TataThanapat/CURSR-V-Flight-Computer/Main board/Main board.stl

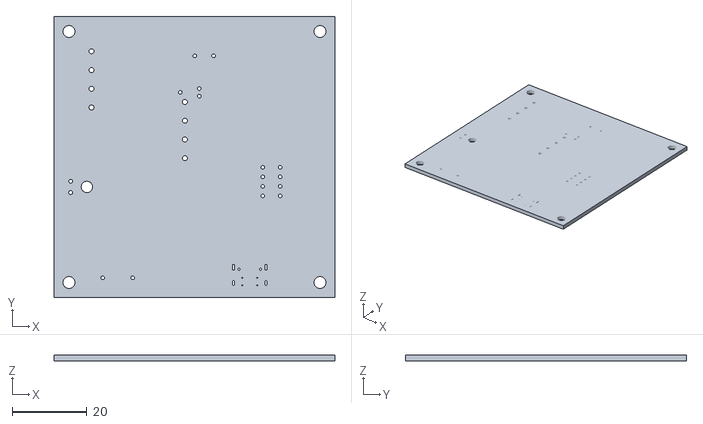
[picture p1: CAD file, 2026-03-27]
Main board/Main board.stl
75.0 x 75.0 x 1.51
