TataThanapat/CURSR-V-Flight-Computer/ICM45686_Breakout/ICM45686_Breakout.kicad_pcb

## KiCad design ICM45686_Breakout/ICM45686_Breakout.kicad_pcb (2026-10-14)

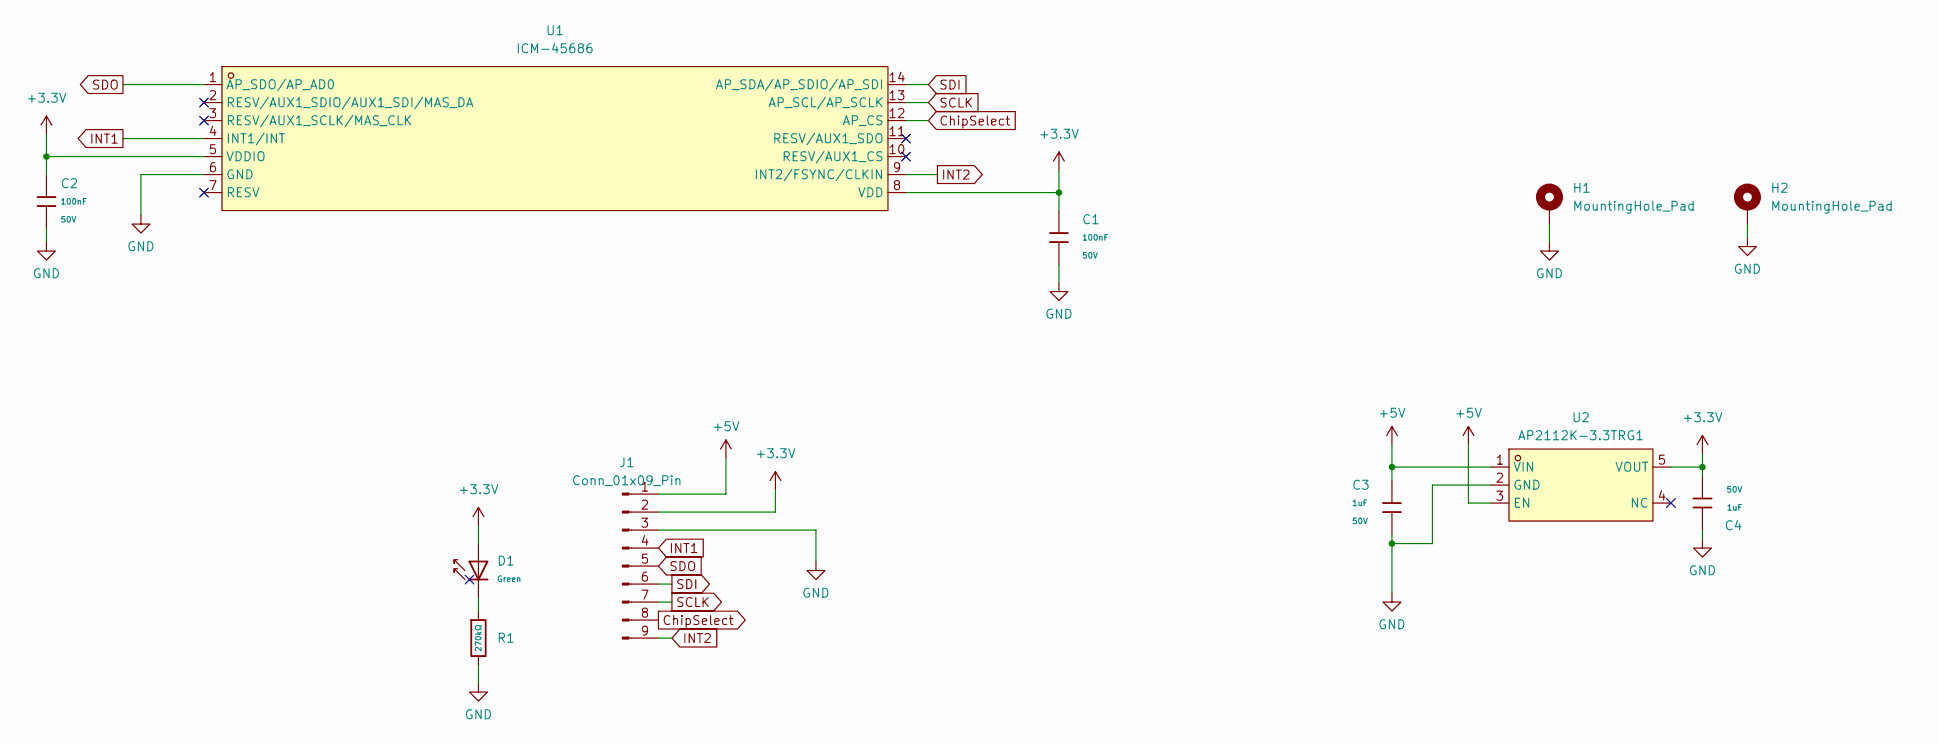
[picture p2: schematic ICM45686_Breakout.kicad_sch]

Parts:
C1, C2: 100nF; C_0603; Voltage Rated 50V; Tolerance ±10%; Part CC0603KRX7R9BB104; LCSC C14663
C3, C4: 1uF; C_0805; Voltage Rated 50V; Tolerance ±10%; Part CL21B105KBFNNNE; LCSC C28323
D1: Green; D_0805; Part KT-0805G; LCSC C2297
H1, H2: MountingHole_Pad; MountingHole_2.2mm_M2_ISO7380_Pad
J1: Conn_01x09_Pin; PinHeader_1x09_P2.54mm_Vertical
R1: 270kΩ; R_0603; Overload Voltage (Max) 75V; Tolerance ±1%; Part 0603WAF2703T5E; LCSC C22965
U1: ICM-45686; LGA-14_L3.0-W2.5-P0.50-TL; LCSC Part C22459454
U2: AP2112K-3.3TRG1; SOT-25-5_L2.9-W1.6-P0.95-LS2.8-BL; LCSC Part C51118

Connections:
+3.3V: C1.1, C2.1, C4.2, D1.2, J1.2, U1.5 (VDDIO), U1.8 (VDD), U2.5 (VOUT)
+5V: C3.1, J1.1, U2.1 (VIN), U2.3 (EN)
ChipSelect: J1.8, U1.12 (AP_CS)
GND: C1.2, C2.2, C3.2, C4.1, H1.1, H2.1, J1.3, R1.2, U1.6 (GND), U2.2 (GND)
INT1: J1.4, U1.4 (INT1/INT)
INT2: J1.9, U1.9 (INT2/FSYNC/CLKIN)
unnamed: D1.1, R1.1
SCLK: J1.7, U1.13 (AP_SCL/AP_SCLK)
SDI: J1.6, U1.14 (AP_SDA/AP_SDIO/AP_SDI)
SDO: J1.5, U1.1 (AP_SDO/AP_AD0)

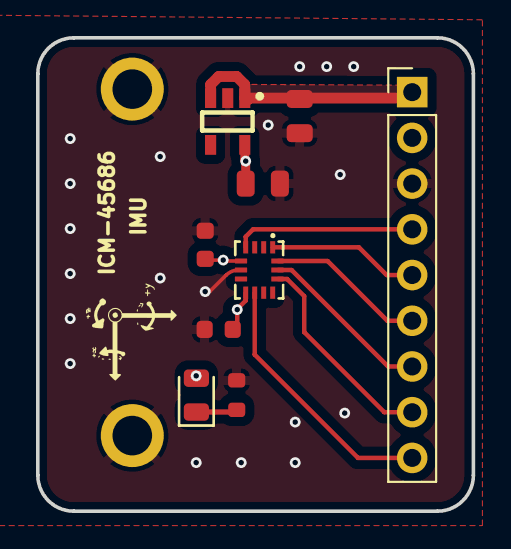
[picture p3: board ICM45686_Breakout.kicad_pcb from above]

Board: 4 copper layers, 24.2 x 26.3 mm, 11 parts (0 on the bottom side), 10 nets.
