TataThanapat/CURSR-V-Flight-Computer/Baro Breakout/Baro Breakout.kicad_pcb

## KiCad design Baro Breakout/Baro Breakout.kicad_pcb (2026-10-14)

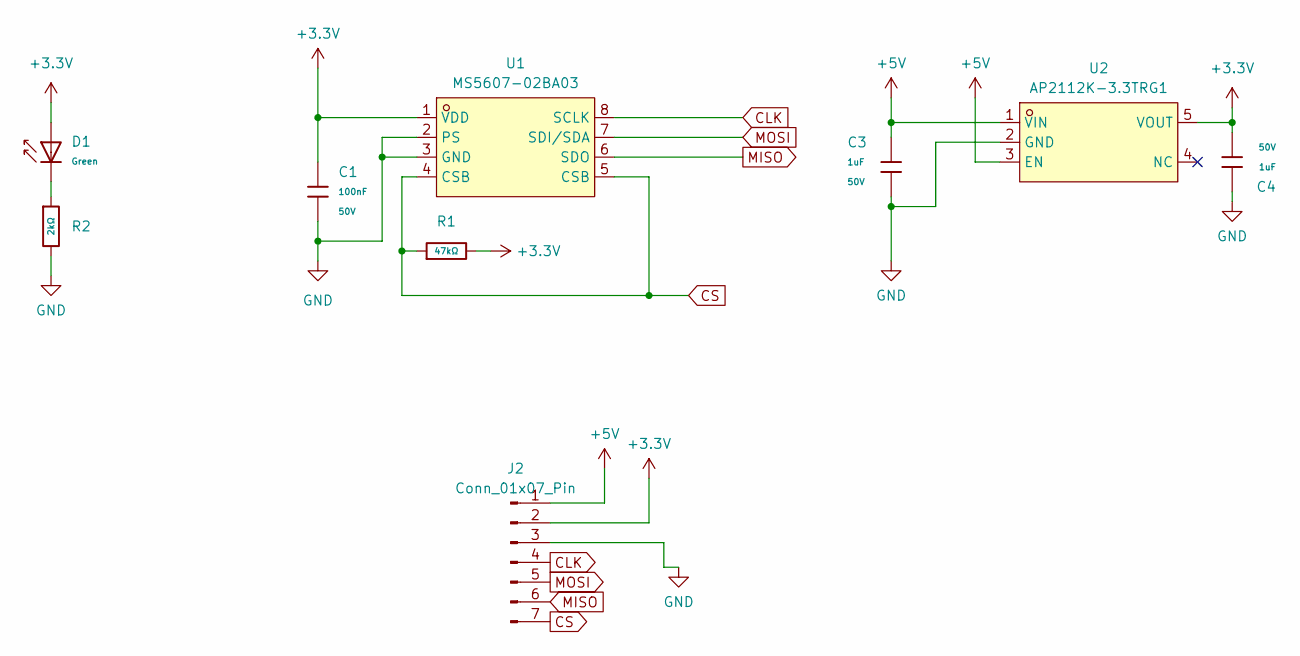
[picture p4: schematic Baro Breakout.kicad_sch]

Parts:
C1: 100nF; C_0603; Voltage Rated 50V; Tolerance ±10%; Part CC0603KRX7R9BB104; LCSC C14663
C3, C4: 1uF; C_0805; Voltage Rated 50V; Tolerance ±10%; Part CL21B105KBFNNNE; LCSC C28323
D1: Green; D_0805; Part KT-0805G; LCSC C2297
J2: Conn_01x07_Pin; PinHeader_1x07_P2.54mm_Vertical
R1: 47kΩ; R_0603; Overload Voltage (Max) 75V; Tolerance ±1%; Part 0603WAF4702T5E; LCSC C25819
R2: 2kΩ; R_0402; Overload Voltage (Max) 50V; Tolerance ±1%; Part 0402WGF2001TCE; LCSC C4109
U1: MS5607-02BA03; SENSOR-SMD_MS560702BA03-50; LCSC Part C9900023641
U2: AP2112K-3.3TRG1; SOT-25-5_L2.9-W1.6-P0.95-LS2.8-BL; LCSC Part C51118

Connections:
+3.3V: C1.1, C4.2, D1.2, J2.2, R1.2, U1.1 (VDD), U2.5 (VOUT)
+5V: C3.1, J2.1, U2.1 (VIN), U2.3 (EN)
CLK: J2.4, U1.8 (SCLK)
CS: J2.7, R1.1, U1.4 (CSB), U1.5 (CSB)
GND: C1.2, C3.2, C4.1, J2.3, R2.2, U1.2 (PS), U1.3 (GND), U2.2 (GND)
MISO: J2.6, U1.6 (SDO)
MOSI: J2.5, U1.7 (SDI/SDA)
unnamed: D1.1, R2.1

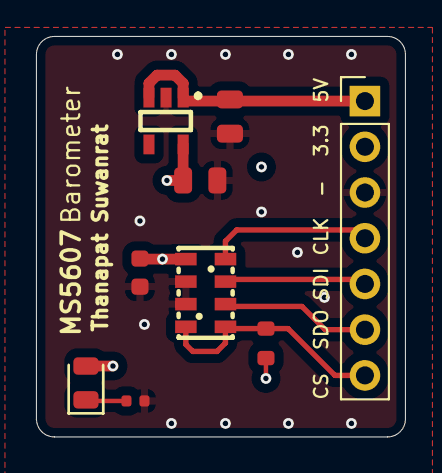
[picture p5: board Baro Breakout.kicad_pcb from above]

Board: 4 copper layers, 20.5 x 22.2 mm, 9 parts (0 on the bottom side), 8 nets.
