TataThanapat/CURSR-V-Flight-Computer/Main board/Main board.kicad_pcb

## KiCad design Main board/Main board.kicad_pcb (2026-10-14)

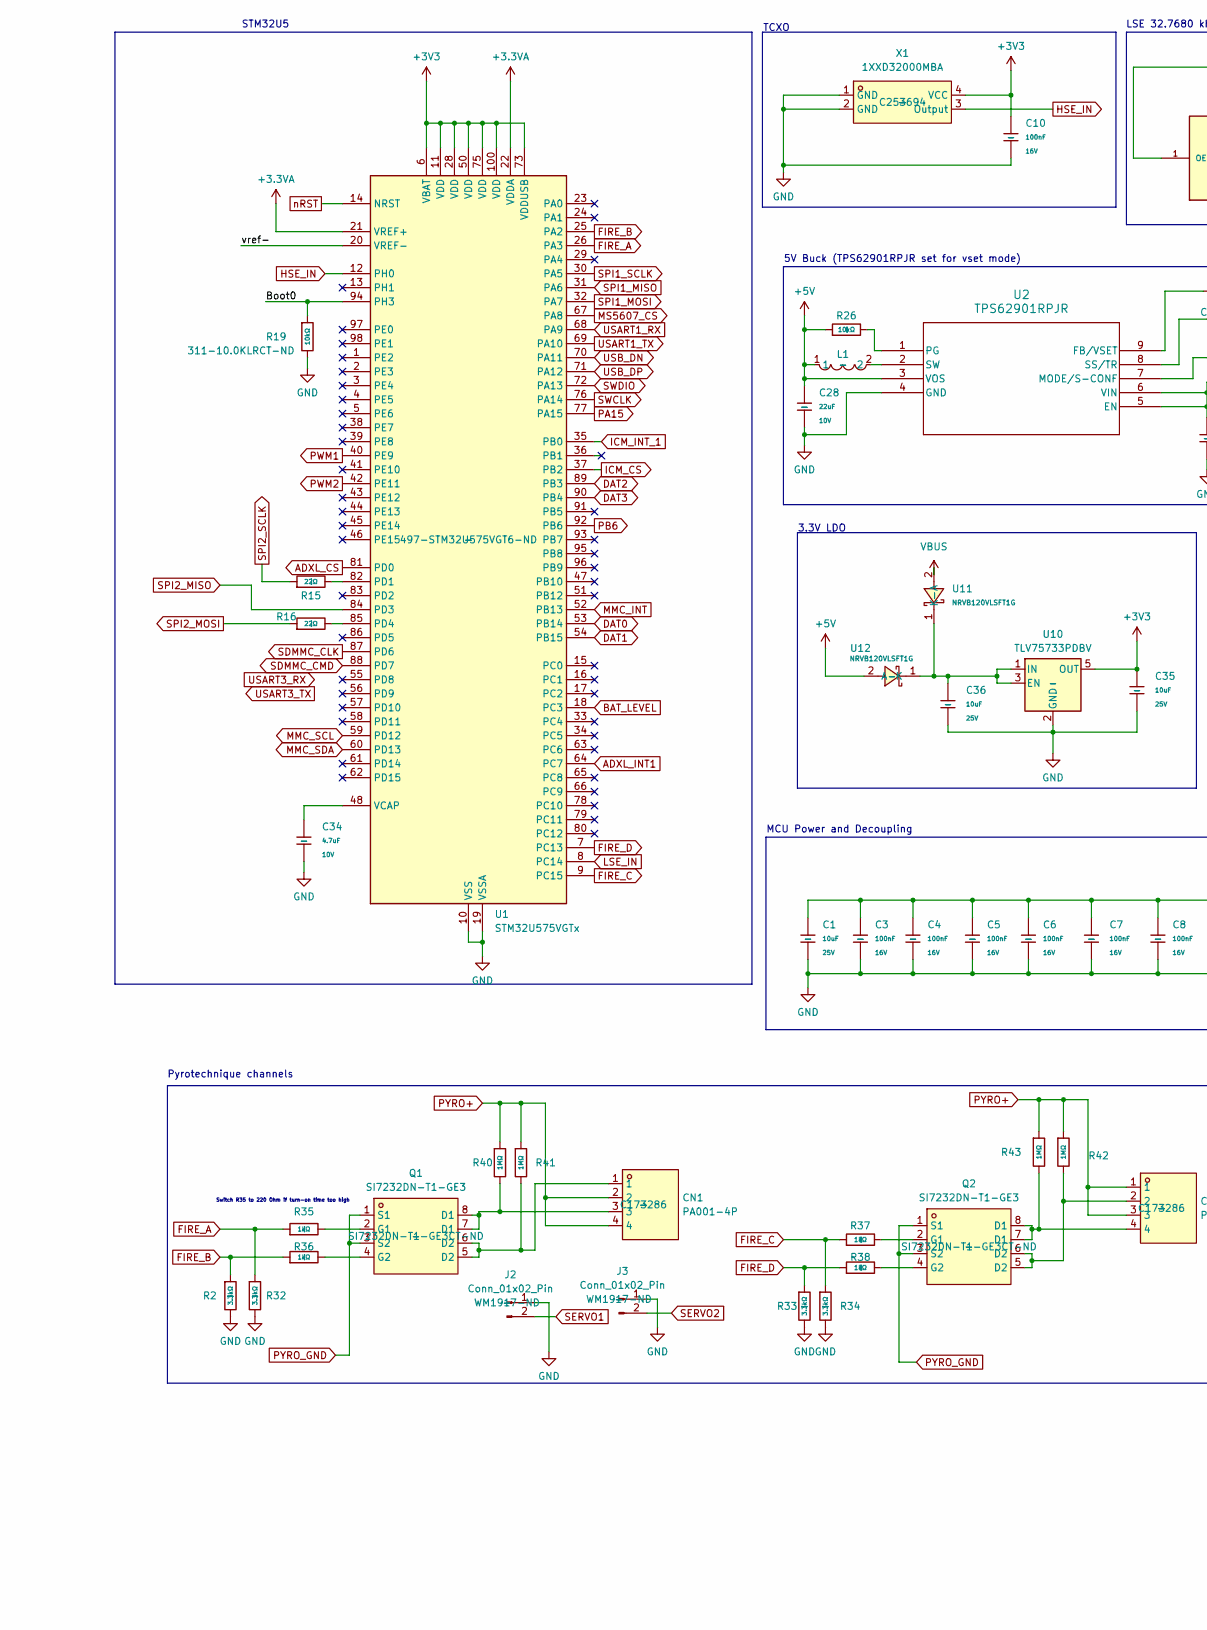
[picture p6: schematic Main board.kicad_sch, CURFA-V SRAD Flight Computer, part in row 1, column 1]

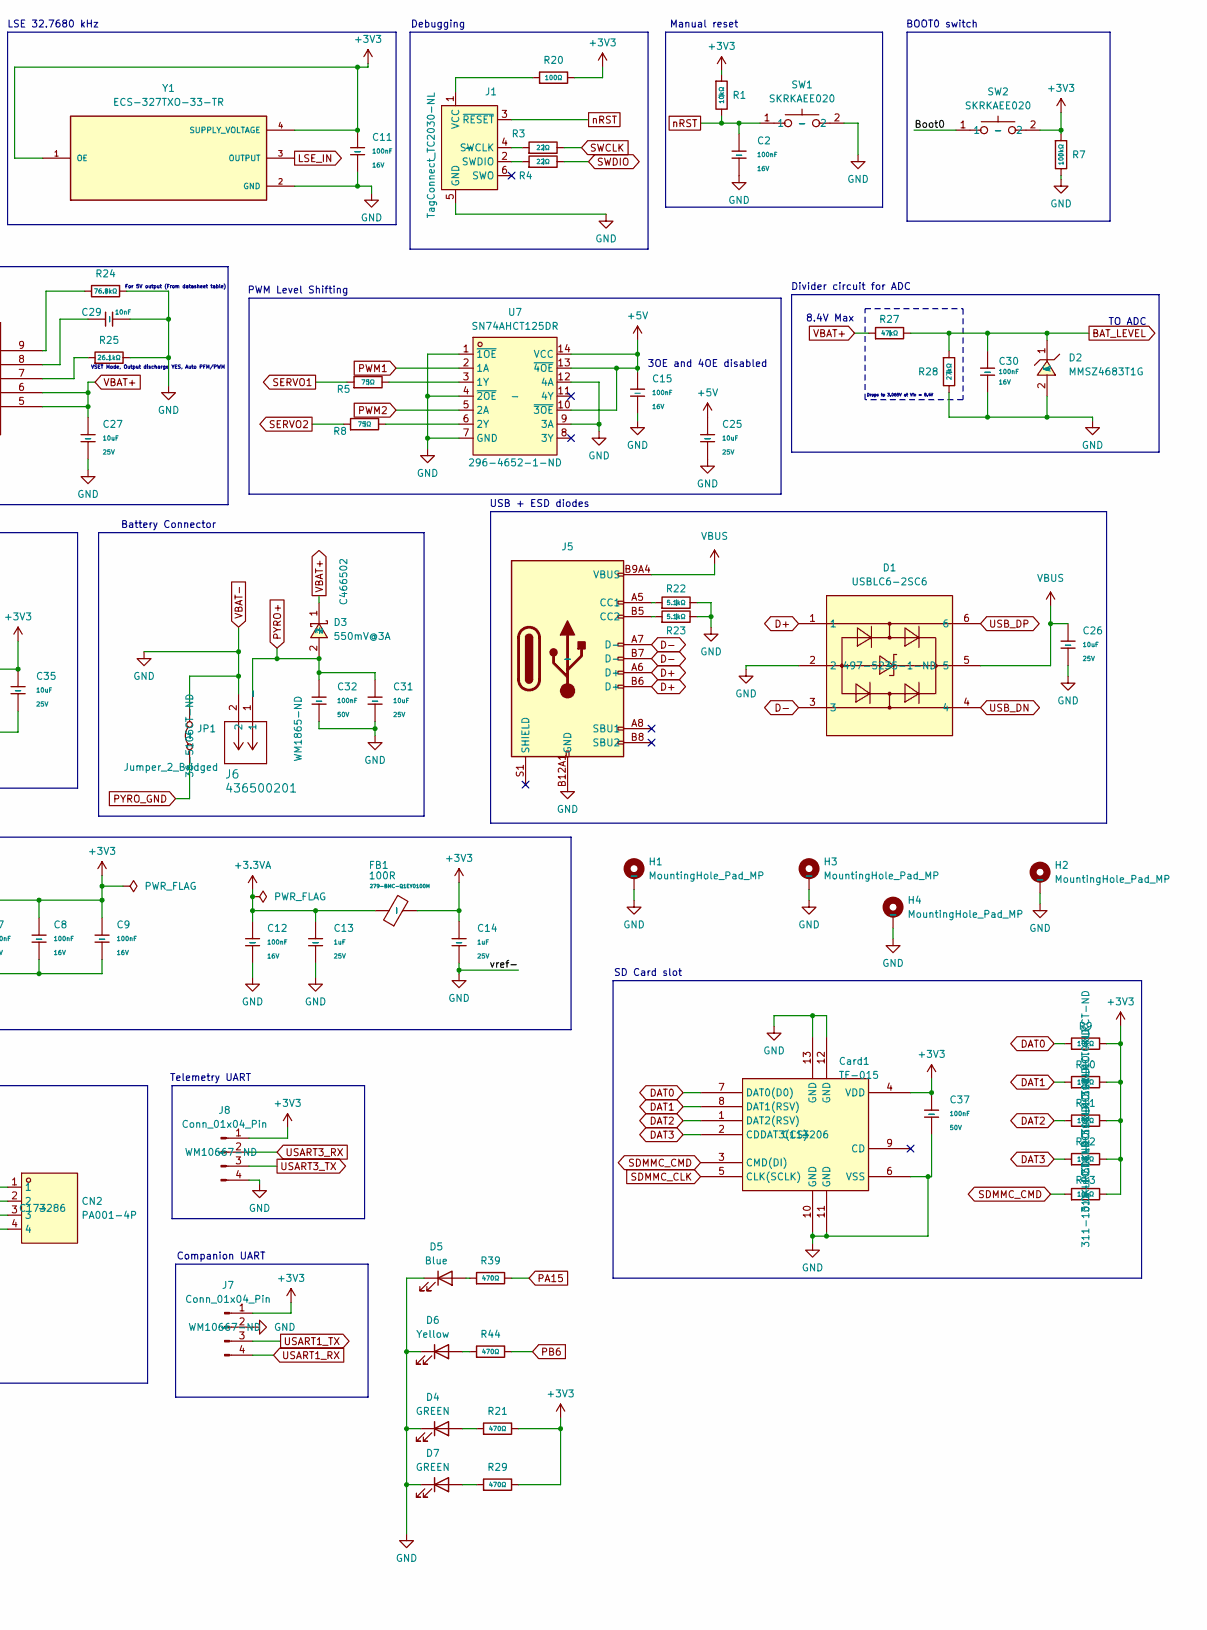
[picture p7: schematic Main board.kicad_sch, CURFA-V SRAD Flight Computer, part in row 1, column 2]

Parts:
C1, C25, C26, C35, C36: 10uF; C_0603; Voltage Rated 25V; Tolerance ±20%; Part CL05A106MQ5NUNC; LCSC C96446
C2, C3, C4, C5, C6, C7, C8, C9, C10, C11, C12, C15, C30: 100nF; C_0402; Voltage Rated 16V; Tolerance ±10%; Part CL05B104KO5NNNC; LCSC C1525
C13, C14: 1uF; C_0402; Voltage Rated 25V; Tolerance ±10%; Part CL05A105KA5NQNC; LCSC C52923
C27, C31: 10uF; C_0603; Voltage Rated 25V; Tolerance ±20%; Part CL10A106MA8NRNC; LCSC C96446
C28: 22uF; C_0805; Voltage Rated 10V; Tolerance ±20%; Part CL10A226MQ8NRNC; LCSC C380338
C29: 10nF; C_0402; Voltage Rated 50V; Tolerance ±10%; Part CL05B103KB5NNNC; LCSC C15195
C32, C37: 100nF; C_0603; Voltage Rated 50V; Tolerance ±10%; Part CC0603KRX7R9BB104; LCSC C14663
C34: 4.7uF; C_0805; Voltage Rated 10V; Tolerance ±20%; Part CL05A475MP5NRNC; LCSC C76639
CN1, CN2: PA001-4P; CONN-TH_4P-P5.08_PA001-4P; LCSC Part C173286
Card1: TF-015; TF-SMD_TF-015; LCSC Part C113206
D1: USBLC6-2SC6; SOT-23-6_L2.9-W1.6-P0.95-LS2.8-BL; LCSC Part C7519
D2: MMSZ4683T1G; SOD-123_L2.8-W1.8-LS3.7-RD; LCSC Part C235985
D3: 550mV@3A; SMA_L4.4-W2.6-LS5.0-RD; LCSC Part C466502
D4, D7: GREEN; WL-SMCW_0603
D5: Blue; WL-SMCW_0603
D6: Yellow; WL-SMCW_0603
FB1: 100R; C_0402_1005Metric_Pad0.74x0.62mm_HandSolder; Part 279-BMC-Q1EY0100M
H1, H2, H3, H4: MountingHole_Pad_MP; MountingHole_3.2mm_M3_DIN965_Pad_TopBottom
J1: TagConnect_TC2030-NL; Tag-Connect_TC2030-IDC-NL_2x03_P1.27mm_Vertical
J2, J3: Conn_01x02_Pin; Molex_Micro-Fit_3.0_43650-0215_1x02_P3.00mm_Vertical; Digikey Part No. WM1917-ND
J5: Connector, USB-TYPE-C-16P; TYPE-C-SMD_HX-TYPE-C-16PIN; LCSC C2927039
J6: 436500201; AMASS_XT30UPB-F_1x02_P5.0mm_Vertical; Digikey Part No. WM1865-ND
J7: Conn_01x04_Pin; CONN_SD-43045-010_04_MOL; Digikey Part No. WM10667-ND
J8: Conn_01x04_Pin; PinHeader_1x04_P2.54mm_Vertical; Digikey Part No. WM10667-ND
JP1: Jumper_2_Bridged; D_0805_2012Metric; Digikey Part No. 36-5106CT-ND
L1: CKCS4018-1UH/N; IND-SMD_L4.0-W4.0; LCSC Part C354578
Q1, Q2: SI7232DN-T1-GE3; POWER-1212-8_L3.3-W3.3-P0.66-LS3.3-BL; LCSC Part C144854
R1, R9, R10, R11, R12, R13, R19: 10kΩ; R_0402; Overload Voltage (Max) 50V; Tolerance ±1%; Part 0402WGF1002TCE; LCSC C25744 (OUT OF STOCK)
R2, R32, R33, R34: 3.3kΩ; R_0402; Overload Voltage (Max) 50V; Tolerance ±1%; Part 0402WGF3301TCE; LCSC C25890
R3, R4, R15, R16: 22Ω; R_0402; Overload Voltage (Max) 50V; Tolerance ±1%; Part 0402WGF220JTCE; LCSC C25092
R5, R8: 75Ω; R_0402; Overload Voltage (Max) 50V; Tolerance ±1%; Part 0402WGF750JTCE; LCSC C25133
R7: 100kΩ; R_0402; Overload Voltage (Max) 50V; Tolerance ±1%; Part 0402WGF1003TCE; LCSC C25741 (OUT OF STOCK)
R20: 100Ω; R_0402; Overload Voltage (Max) 50V; Tolerance ±1%; Part 0402WGF1000TCE; LCSC C25076
R21, R29, R39, R44: 470Ω; R_0402; Overload Voltage (Max) 50V; Tolerance ±1%; Part 0402WGF4700TCE; LCSC C25117
R22, R23: 5.1kΩ; R_0402; Overload Voltage (Max) 50V; Tolerance ±1%; Part 0402WGF5101TCE; LCSC C25905
R24: 76.8kΩ; R_0603; Overload Voltage (Max) 75V; Tolerance ±1%; Part ERJ-P03F7682V; Digikey Part No. 311-76.8KHRCT-ND
R25: 26.1kΩ; R_0603; Overload Voltage (Max) 75V; Tolerance ±1%; Part ERJ-S03F2612V; Digikey Part No. 311-26.1KHRCT-ND
R26: 10kΩ; R_0603; Overload Voltage (Max) 75V; Tolerance ±1%; Part 0603WAF1002T5E; LCSC C25804
R27: 47kΩ; R_0402; Overload Voltage (Max) 50V; Tolerance ±1%; Part 0402WGF4702TCE; LCSC C25792
R28: 27kΩ; R_0402; Overload Voltage (Max) 50V; Tolerance ±1%; Part 0402WGF2702TCE; LCSC C25771
R35, R36, R37, R38: 1kΩ; R_0402; Overload Voltage (Max) 50V; Tolerance ±1%; Part 0402WGF1001TCE; LCSC C11702
R40, R41, R42, R43: 1MΩ; R_0805; Overload Voltage (Max) 150V; Tolerance ±1%; Part 0805W8F1004T5E; LCSC C17514
SW1, SW2: SKRKAEE020; SW-SMD_L3.9-W3.0-P4.45; LCSC Part C115357
U1: STM32U575VGTx; LQFP-100_14x14mm_P0.5mm; Digikey Part No. 497-STM32U575VGT6-ND
U2: TPS62901RPJR; QFN_902RPJR_TEX; Digikey Part No. 296-TPS62901RPJRCT-ND
U7: SN74AHCT125DR; SOIC-14_L8.7-W3.9-P1.27-LS6.0-BL; LCSC Part C155176
U10: TLV75733PDBV; SOT-23-5; Digikey Part No. 296-50414-1-ND
U11, U12: NRVB120VLSFT1G; SOD-123_L2.7-W1.6-LS3.7-RD-1; LCSC Part C604264
X1: 1XXD32000MBA; OSC-SMD_4P-L2.0-W1.6-BL_1XXD; LCSC Part C253694
Y1: ECS-327TXO-33-TR; OSC_ECS-327TXO-33-TR; PARTREV Rev.2019

Connections:
+3.3VA: C12.1, C13.1, FB1.1, U1.21 (VREF+), U1.22 (VDDA)
+3V3: C1.1, C3.1, C4.1, C5.1, C6.1, C7.1, C8.1, C9.1, C10.1, C11.1, C14.1, C35.1, C37.1, Card1.4 (VDD), FB1.2, J7.1, J8.1, R1.1, R7.1, R9.2, R10.2, R11.2, R12.2, R13.2, R20.2, R21.2, R29.2, SW2.2, U1.6 (VBAT), U1.11 (VDD), U1.28 (VDD), U1.50 (VDD), U1.73 (VDDUSB), U1.75 (VDD), U1.100 (VDD), U10.5 (OUT), X1.4 (VCC), Y1.1 (OE), Y1.4 (SUPPLY_VOLTAGE); also elsewhere on the board
+5V: C15.1, C25.1, C28.1, L1.1, R26.1, U2.3 (VOS), U7.10 (~3OE), U7.13 (~4OE), U7.14 (VCC), U12.2 (A)
/Boot0: R19.1, SW2.1, U1.94 (PH3)
ADXL_CS: U1.81 (PD0); also elsewhere on the board
ADXL_INT1: U1.64 (PC7); also elsewhere on the board
BAT_LEVEL: C30.1, D2.1 (C), R27.2, R28.1, U1.18 (PC3)
D+: D1.1, J5.A6 (D+), J5.B6 (D+)
D-: D1.3, J5.A7 (D-), J5.B7 (D-)
DAT0: Card1.7 (DAT0(D0)), R9.1, U1.53 (PB14)
DAT1: Card1.8 (DAT1(RSV)), R10.1, U1.54 (PB15)
DAT2: Card1.1 (DAT2(RSV)), R11.1, U1.89 (PB3)
DAT3: Card1.2 (CDDAT3(CS)), R12.1, U1.90 (PB4)
FIRE_A: R32.1, R35.1, U1.26 (PA3)
FIRE_B: R2.1, R36.1, U1.25 (PA2)
FIRE_C: R34.1, R37.1, U1.9 (PC15)
FIRE_D: R33.1, R38.1, U1.7 (PC13)
HSE_IN: U1.12 (PH0), X1.3 (Output)
ICM_CS: U1.37 (PB2); also elsewhere on the board
ICM_INT_1: U1.35 (PB0); also elsewhere on the board
LSE_IN: U1.8 (PC14), Y1.3 (OUTPUT)
MMC_INT: U1.52 (PB13); also elsewhere on the board
MMC_SCL: U1.59 (PD12); also elsewhere on the board
MMC_SDA: U1.60 (PD13); also elsewhere on the board
MS5607_CS: U1.67 (PA8); also elsewhere on the board
unnamed: CN1.1, Q1.5 (D2), Q1.6 (D2), R41.2
unnamed: CN1.3, Q1.7 (D1), Q1.8 (D1), R40.2
unnamed: CN2.2, Q2.5 (D2), Q2.6 (D2), R42.2
unnamed: CN2.4, Q2.7 (D1), Q2.8 (D1), R43.2
unnamed: D4.2 (A), R21.1
unnamed: D5.2 (A), R39.1
unnamed: D6.2 (A), R44.1
unnamed: D7.2 (A), R29.1
unnamed: J1.4 (SWCLK), R3.1
unnamed: J1.2 (SWDIO), R4.1
unnamed: J1.1 (VCC), R20.1
unnamed: J5.A5 (CC1), R22.1
unnamed: J5.B5 (CC2), R23.1
unnamed: Q1.2 (G1), R35.2
unnamed: Q1.4 (G2), R36.2
unnamed: Q2.2 (G1), R37.2
unnamed: Q2.4 (G2), R38.2
unnamed: R15.2, U1.82 (PD1)
unnamed: R16.2, U1.85 (PD4)
unnamed: C34.1, U1.48 (VCAP)
unnamed: R24.2, U2.9 (FB/VSET)
unnamed: R25.1, U2.7 (MODE/S-CONF)
unnamed: R26.2, U2.1 (PG)
unnamed: C29.1, U2.8 (SS/TR)
unnamed: L1.2, U2.2 (SW)
unnamed: R5.2, U7.3 (1Y)
unnamed: R8.2, U7.6 (2Y)
unnamed: C36.1, U10.1 (IN), U10.3 (EN), U11.1 (K), U12.1 (K)
PA15: R39.2, U1.77 (PA15)
PB6: R44.2, U1.92 (PB6)
PWM1: U1.40 (PE9), U7.2 (1A)
PWM2: U1.42 (PE11), U7.5 (2A)
PYRO+: C31.1, C32.1, CN1.2, CN1.4, CN2.1, CN2.3, D3.2, J6.1, R40.1, R41.1, R42.1, R43.1
PYRO_GND: JP1.1 (A), Q1.1 (S1), Q1.3 (S2), Q2.1 (S1), Q2.3 (S2)
SDMMC_CLK: Card1.5 (CLK(SCLK)), U1.87 (PD6)
SDMMC_CMD: Card1.3 (CMD(DI)), R13.1, U1.88 (PD7)
SERVO1: J2.2, R5.1
SERVO2: J3.2, R8.1
SPI1_MISO: U1.31 (PA6); also elsewhere on the board
SPI1_MOSI: U1.32 (PA7); also elsewhere on the board
SPI1_SCLK: U1.30 (PA5); also elsewhere on the board
SPI2_MISO: U1.84 (PD3); also elsewhere on the board
SPI2_MOSI: R16.1; also elsewhere on the board
SPI2_SCLK: R15.1; also elsewhere on the board
SWCLK: R3.2, U1.76 (PA14)
SWDIO: R4.2, U1.72 (PA13)
USART1_RX: J7.4, U1.68 (PA9)
USART1_TX: J7.3, U1.69 (PA10)
USB_DN: D1.4, U1.70 (PA11)
USB_DP: D1.6, U1.71 (PA12)
VBAT+: C27.1, D3.1, R27.1, U2.5 (EN), U2.6 (VIN)
VBAT-: C1.2, C2.2, C3.2, C4.2, C5.2, C6.2, C7.2, C8.2, C9.2, C10.2, C11.2, C12.2, C13.2, C14.2, C15.2, C25.2, C26.2, C27.2, C28.2, C29.2, C30.2, C31.2, C32.2, C34.2, C35.2, C36.2, C37.2, Card1.6 (VSS), Card1.10 (GND), Card1.11 (GND), Card1.12 (GND), Card1.13 (GND), D1.2, D2.2 (A), D4.1 (K), D5.1 (K), D6.1 (K), D7.1 (K), H1.1, H2.1, H3.1, H4.1, J1.5 (GND), J2.1, J3.1, J5.A12B1 (GND), J5.B12A1 (GND), J6.2, J7.2, J8.4, JP1.2 (B), R2.2, R7.2, R19.2, R22.2, R23.2, R24.1, R25.2, R28.2, R32.2, R33.2, R34.2, SW1.2, U1.10 (VSS), U1.19 (VSSA), U1.20 (VREF-), U1.27 (VSS), U1.49 (VSS), U1.74 (VSS), U1.99 (VSS), U2.4 (GND), U7.1 (~1OE), U7.4 (~2OE), U7.7 (GND), U7.9 (3A), U7.12 (4A), U10.2 (GND), X1.1 (GND), X1.2 (GND), Y1.2 (GND); also elsewhere on the board
VBUS: C26.1, D1.5, J5.A9B4 (VBUS), J5.B9A4 (VBUS), U11.2 (A)
nRST: C2.1, J1.3 (~RESET), R1.2, SW1.1, U1.14 (NRST)

Notes on the sheet:
Divider circuit for ADC
Debugging
SD Card slot
PWM Level Shifting
Telemetry UART
Manual reset
Companion UART
Battery Connector
STM32U5
Switch R35 to 220 Ohm if turn-on time too high
5V Buck (TPS62901RPJR set for vset mode)
Pyrotechnique channels
TCXO
3.3V LDO
TO ADC
8.4V Max
LSE 32.7680 kHz
3OE and 4OE disabled
USB + ESD diodes
For 5V output (From datasheet table)
Drops to 3.065V at Vin = 8.4V
VSET Mode, Output discharge YES, Auto PFM/PWM
MCU Power and Decoupling
BOOT0 switch

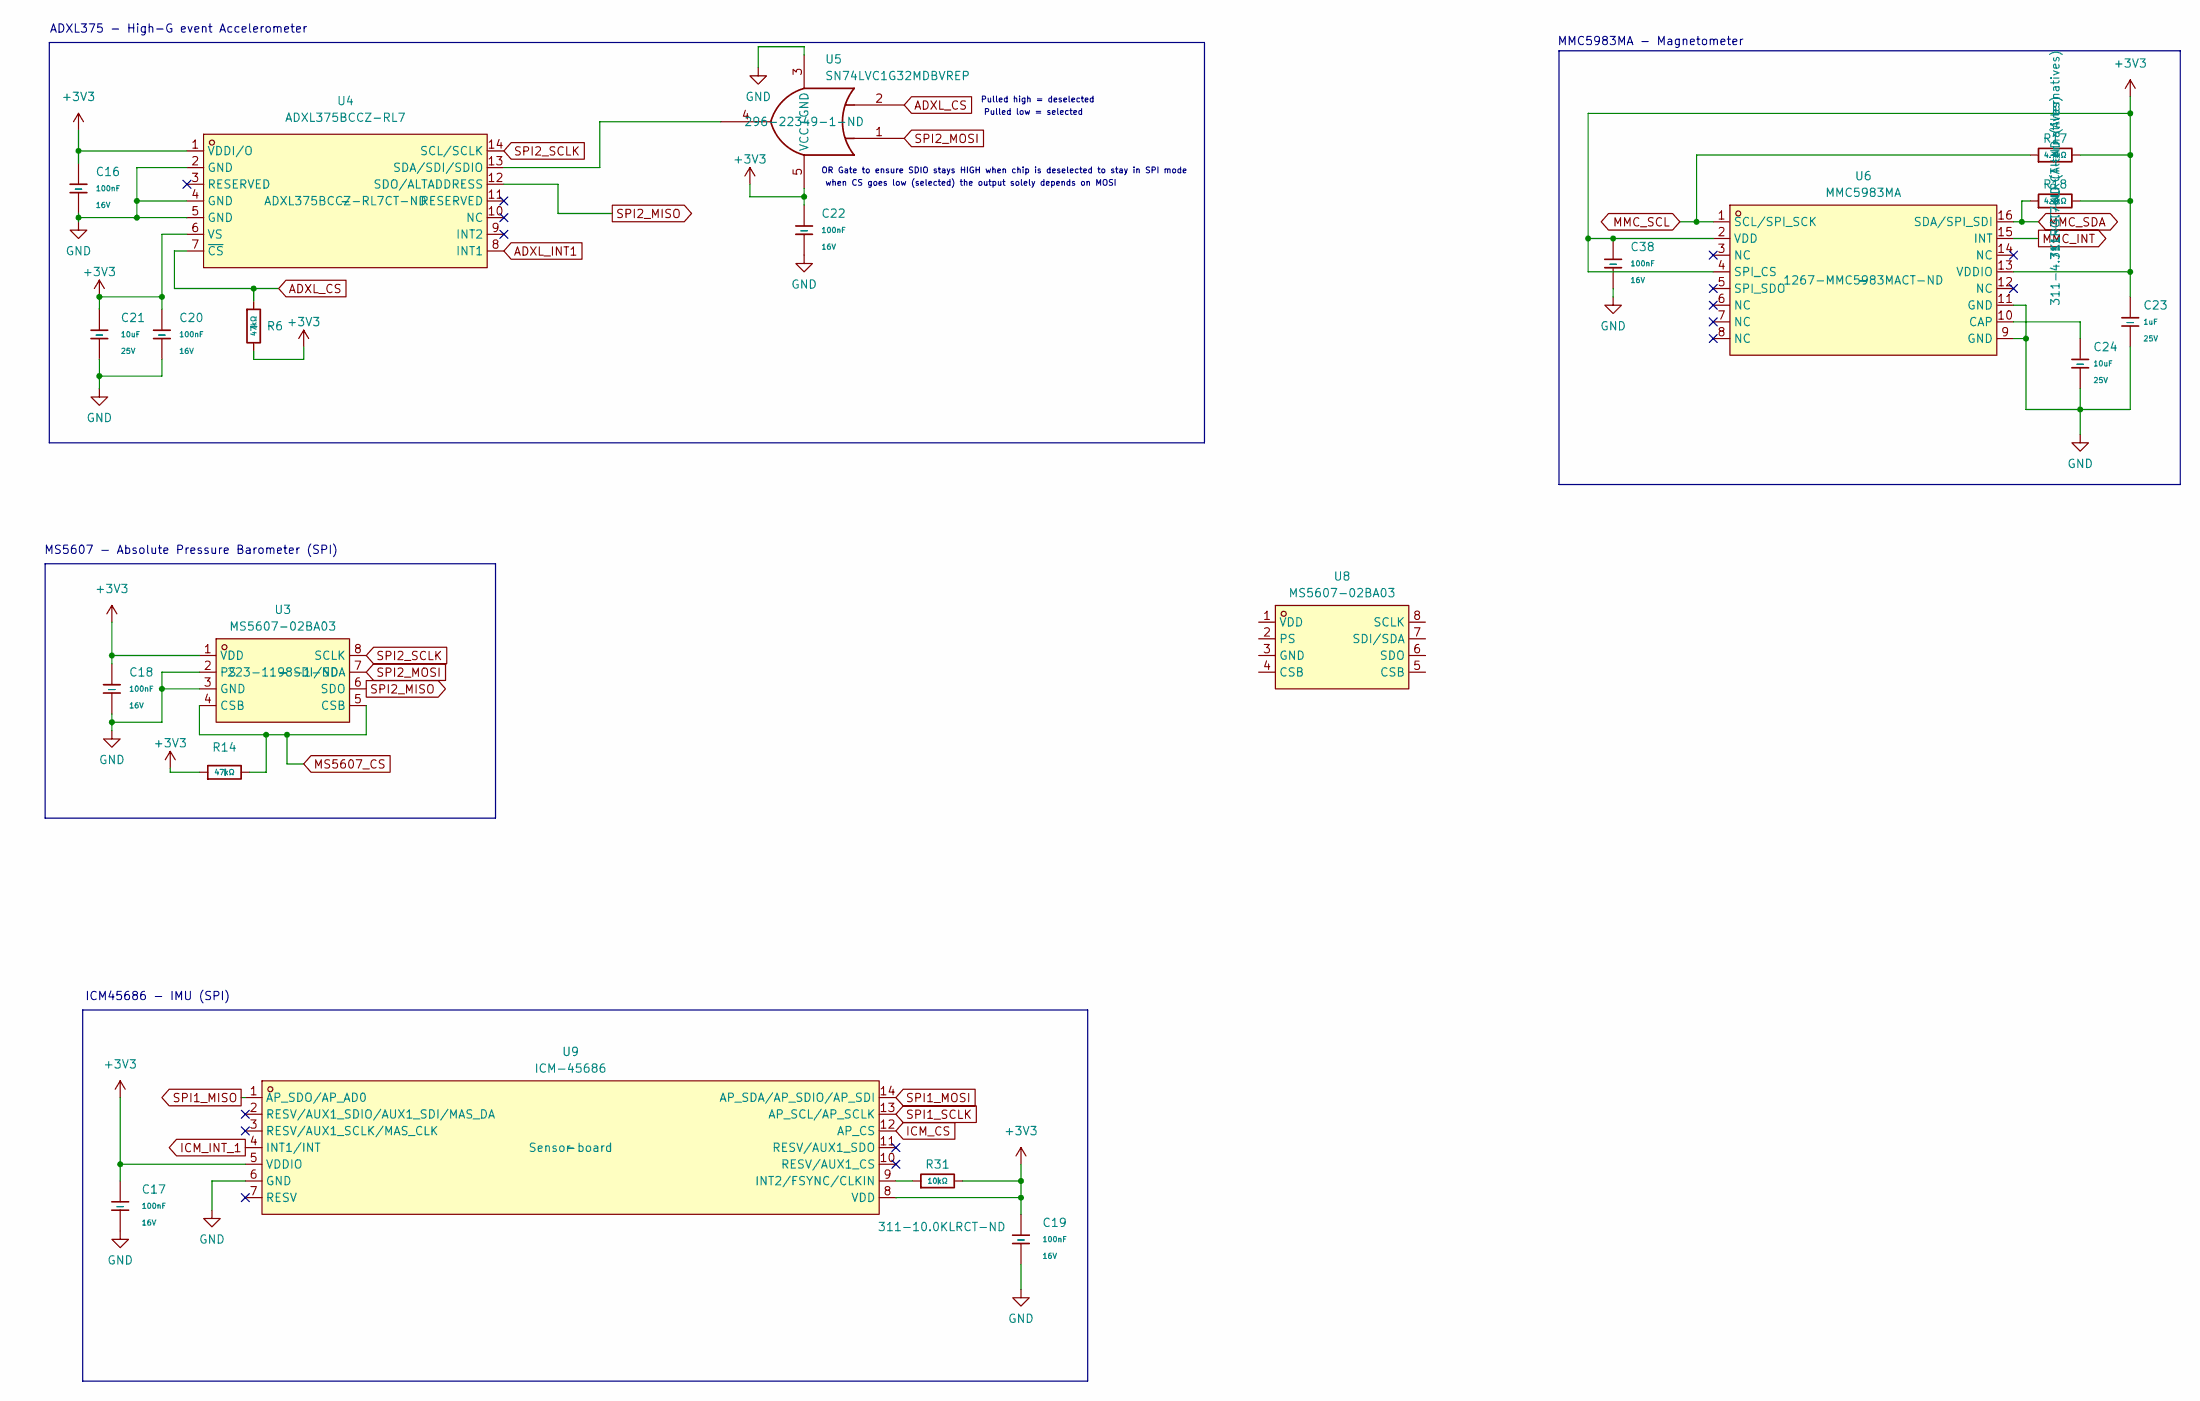
[picture p8: schematic untitled.kicad_sch]

Parts:
C16, C17, C18, C19, C20, C22, C38: 100nF; C_0402; Voltage Rated 16V; Tolerance ±10%; Part CL05B104KO5NNNC; LCSC C1525
C21, C24: 10uF; C_0603; Voltage Rated 25V; Tolerance ±20%; Part CL05A106MQ5NUNC; LCSC C96446
C23: 1uF; C_0402; Voltage Rated 25V; Tolerance ±10%; Part CL05A105KA5NQNC; LCSC C52923
R6, R14: 47kΩ; R_0402; Overload Voltage (Max) 50V; Tolerance ±1%; Part 0402WGF4702TCE; LCSC C25792
R17, R18: 4.7kΩ; R_0402; Overload Voltage (Max) 50V; Tolerance ±1%; Part 0402WGF4701TCE; LCSC C25900 (OUT OF STOCK)
R31: 10kΩ; R_0402; Overload Voltage (Max) 50V; Tolerance ±1%; Part 0402WGF1002TCE; LCSC C25744 (OUT OF STOCK)
U3, U8: MS5607-02BA03; SENSOR-SMD_MS560702BA03-50; LCSC Part C9900023641
U4: ADXL375BCCZ-RL7; LGA-14_L5.0-W3.0-P0.80-BL; LCSC Part C481898
U5: SN74LVC1G32MDBVREP; DBV5; Digikey Part No. 296-22349-1-ND
U6: MMC5983MA; LGA-16_L3.0-W3.0-P0.50-BL_SQ; LCSC Part C404329
U9: ICM-45686; LGA-14_L3.0-W2.5-P0.50-TL; LCSC Part C22459454

Connections:
+3V3: C16.1, C17.1, C18.1, C19.1, C20.1, C21.1, C22.1, C23.1, C38.1, R6.2, R14.1, R17.2, R18.2, R31.2, U3.1 (VDD), U4.1 (VDDI/O), U4.6 (VS), U5.5 (VCC), U6.2 (VDD), U6.4 (SPI_CS), U6.13 (VDDIO), U9.5 (VDDIO), U9.8 (VDD); also elsewhere on the board
ADXL_CS: R6.1, U4.7 (~CS), U5.2; also elsewhere on the board
ADXL_INT1: U4.8 (INT1); also elsewhere on the board
ICM_CS: U9.12 (AP_CS); also elsewhere on the board
ICM_INT_1: U9.4 (INT1/INT); also elsewhere on the board
MMC_INT: U6.15 (INT); also elsewhere on the board
MMC_SCL: R17.1, U6.1 (SCL/SPI_SCK); also elsewhere on the board
MMC_SDA: R18.1, U6.16 (SDA/SPI_SDI); also elsewhere on the board
MS5607_CS: R14.2, U3.4 (CSB), U3.5 (CSB); also elsewhere on the board
unnamed: U4.13 (SDA/SDI/SDIO), U5.4
unnamed: C24.1, U6.10 (CAP)
unnamed: R31.1, U9.9 (INT2/FSYNC/CLKIN)
SPI1_MISO: U9.1 (AP_SDO/AP_AD0); also elsewhere on the board
SPI1_MOSI: U9.14 (AP_SDA/AP_SDIO/AP_SDI); also elsewhere on the board
SPI1_SCLK: U9.13 (AP_SCL/AP_SCLK); also elsewhere on the board
SPI2_MISO: U3.6 (SDO), U4.12 (SDO/ALTADDRESS); also elsewhere on the board
SPI2_MOSI: U3.7 (SDI/SDA), U5.1; also elsewhere on the board
SPI2_SCLK: U3.8 (SCLK), U4.14 (SCL/SCLK); also elsewhere on the board
VBAT-: C16.2, C17.2, C18.2, C19.2, C20.2, C21.2, C22.2, C23.2, C24.2, C38.2, U3.2 (PS), U3.3 (GND), U4.2 (GND), U4.4 (GND), U4.5 (GND), U5.3 (GND), U6.9 (GND), U6.11 (GND), U9.6 (GND); also elsewhere on the board

Notes on the sheet:
Pulled low = selected
MS5607 - Absolute Pressure Barometer (SPI)
MMC5983MA - Magnetometer
ICM45686 - IMU (SPI)
Pulled high = deselected
OR Gate to ensure SDIO stays HIGH when chip is deselected to stay in SPI mode
when CS goes low (selected) the output solely depends on MOSI
ADXL375 - High-G event Accelerometer

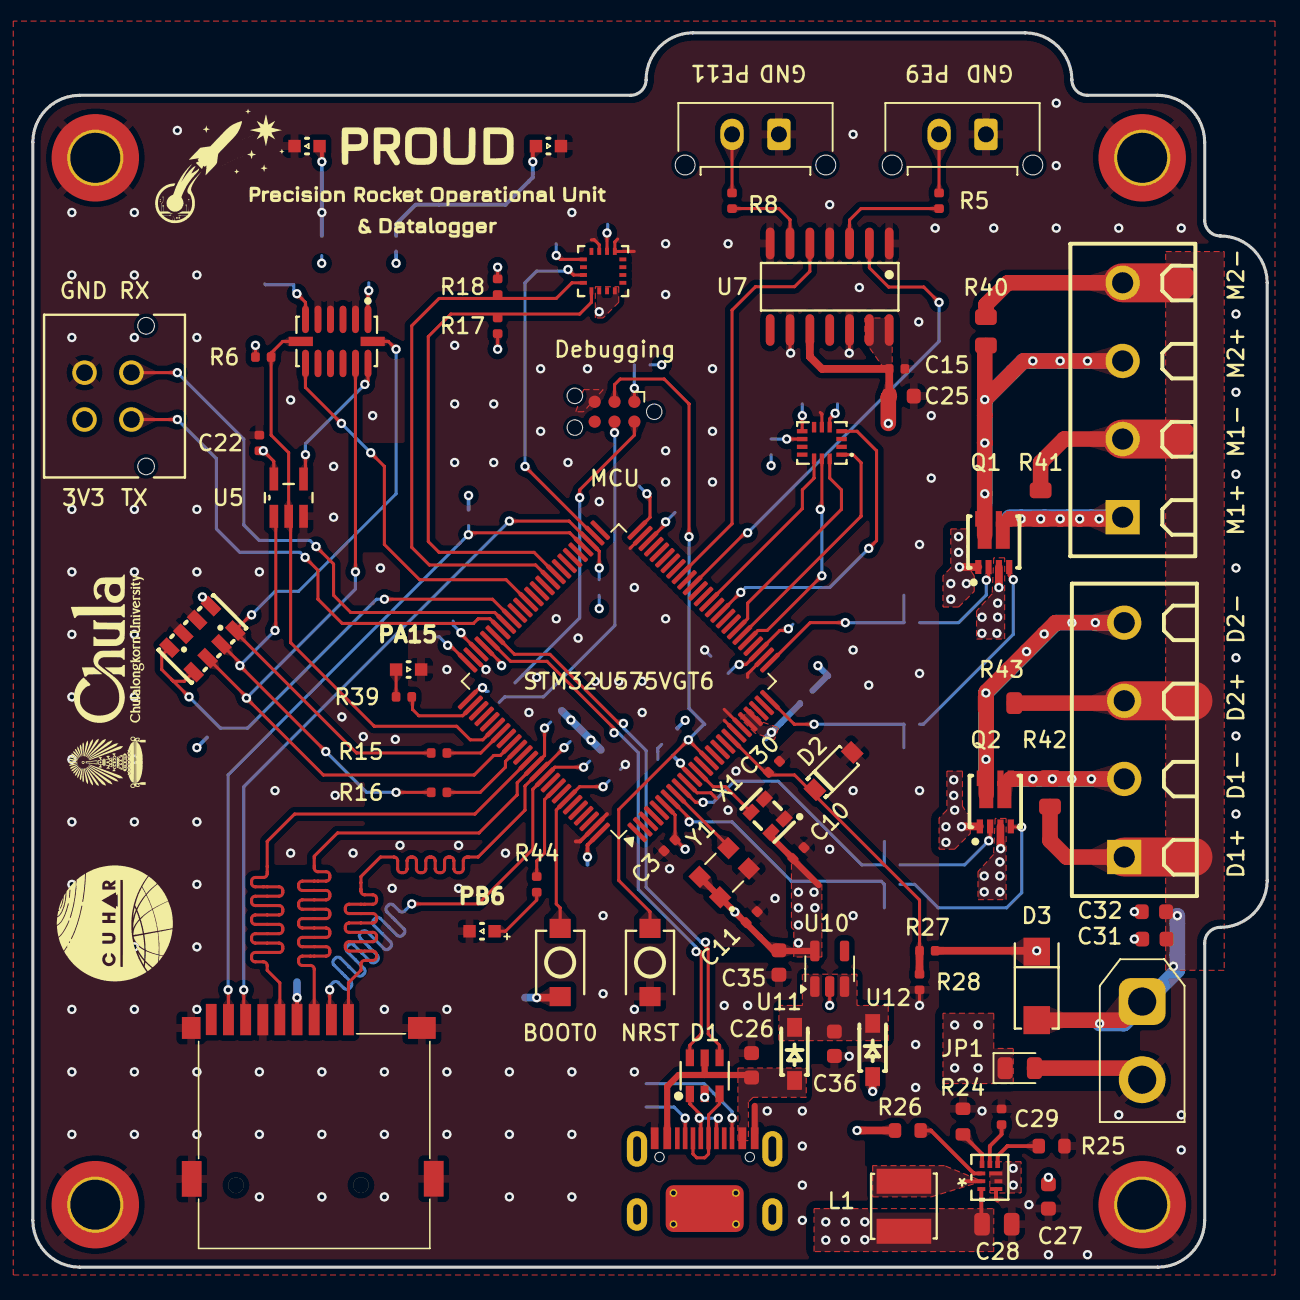
[picture p9: board Main board.kicad_pcb from above]

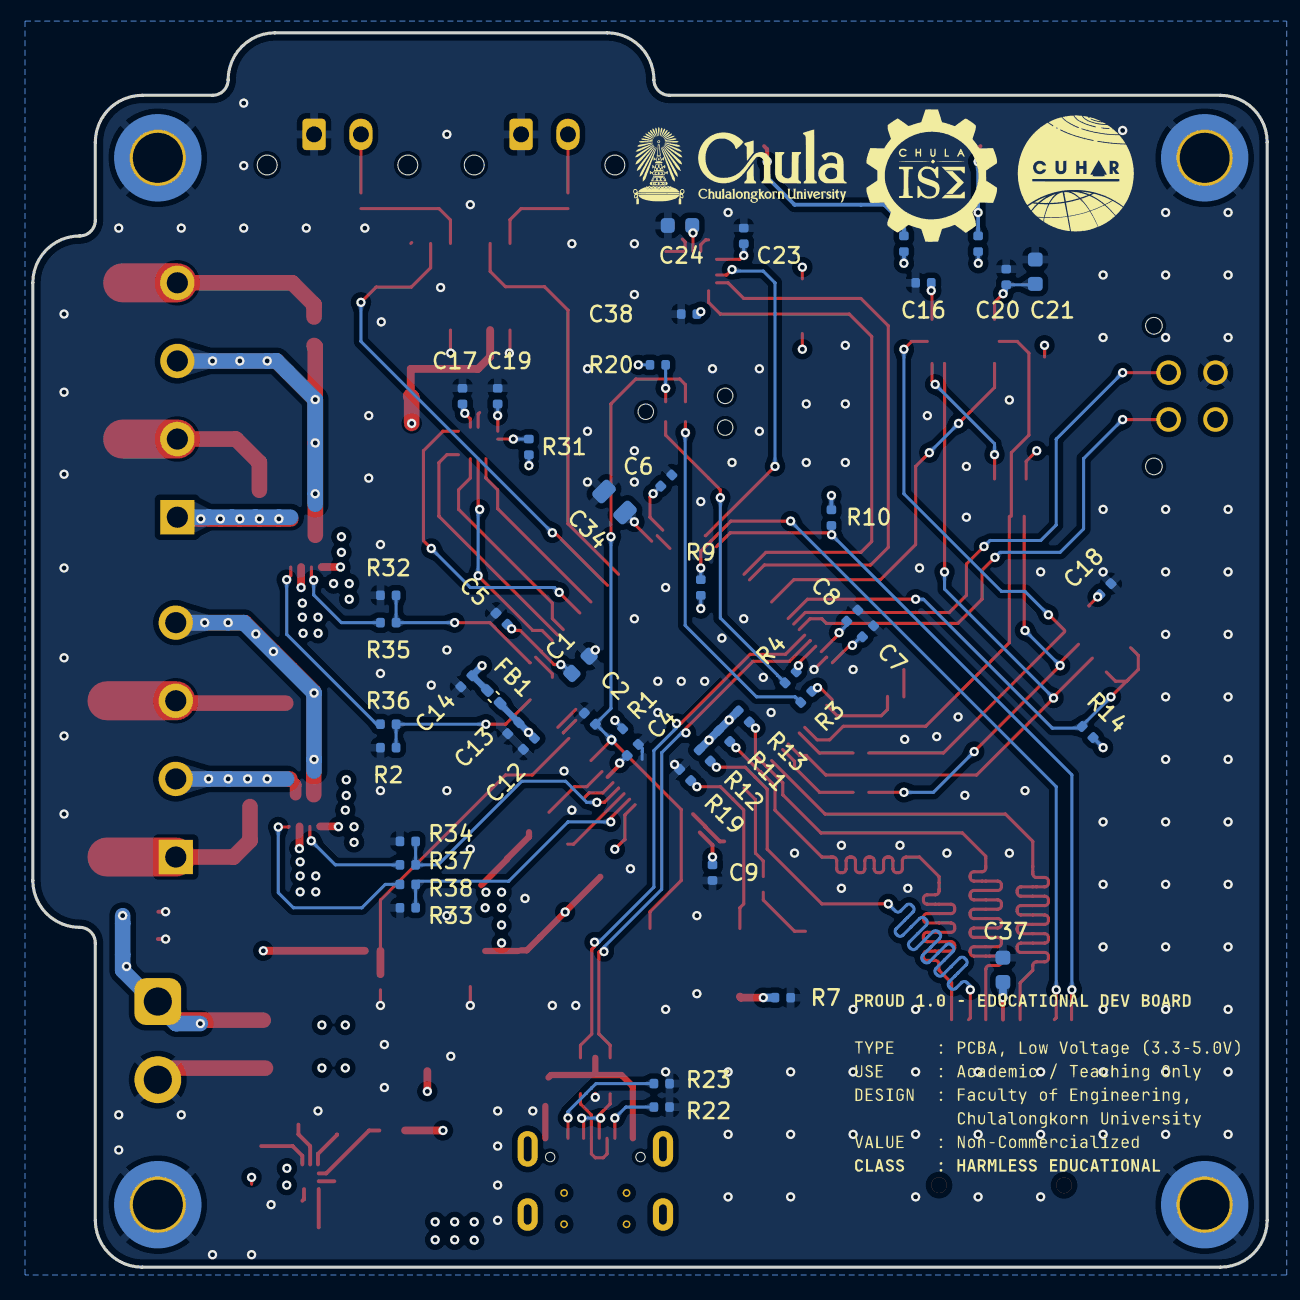
[picture p10: board Main board.kicad_pcb from below]

Board: 4 copper layers, 79.0 x 79.0 mm, 120 parts (48 on the bottom side), 82 nets.
