TataThanapat/CURSR-V-Flight-Computer/FlightCompitor/FlightCompitor.ioc

Mcu.UserName=STM32U575VGTx
PA0.Signal=UART4_TX
PA1.Signal=UART4_RX
PA10.Signal=USART1_RX
PA11.Signal=USB_OTG_FS_DM
PA12.Signal=USB_OTG_FS_DP
PA9.Signal=USART1_TX
PB1.Signal=ADC1_IN16
PB6.Signal=I2C1_SCL
PB7.Signal=I2C1_SDA
PC10.Signal=SDMMC1_D2
PC11.Signal=SDMMC1_D3
PC12.Signal=SDMMC1_CK
PC8.Signal=SDMMC1_D0
PC9.Signal=SDMMC1_D1
PD0.GPIO_Label=MS5607_CS
PD0.Signal=GPIO_Output
PD1.Signal=SPI2_SCK
PD10.GPIO_Label=ADXL_INT1
PD10.Signal=GPIO_Input
PD11.GPIO_Label=ADXL_INT2
PD11.Signal=GPIO_Input
PD12.GPIO_Label=MAG_SCL
PD12.Signal=I2C4_SCL
PD13.GPIO_Label=MAG_SDA
PD13.Signal=I2C4_SDA
PD2.Signal=SDMMC1_CMD
PD3.Signal=SPI2_MISO
PD4.Signal=SPI2_MOSI
PD5.Signal=USART2_TX
PD6.Signal=USART2_RX
PD8.Signal=USART3_TX
PD9.Signal=USART3_RX
PE10.GPIO_Label=ICM_INT1
PE10.Signal=GPIO_Input
PE11.GPIO_Label=ICM_INT2
PE11.Signal=GPIO_Input
PE12.GPIO_Label=ICM_CS
PE12.Signal=GPIO_Output
PE13.Signal=SPI1_SCK
PE14.Signal=SPI1_MISO
PE15.Signal=SPI1_MOSI
