TataThanapat/CURSR-V-Flight-Computer/FlightCompitor/Core/Inc/main.h

#define ICM_INT1_Pin GPIO_PIN_10
#define ICM_INT1_GPIO_Port GPIOE
#define ICM_INT2_Pin GPIO_PIN_11
#define ICM_INT2_GPIO_Port GPIOE
#define ICM_CS_Pin GPIO_PIN_12
#define ICM_CS_GPIO_Port GPIOE
#define ADXL_INT1_Pin GPIO_PIN_10
#define ADXL_INT1_GPIO_Port GPIOD
#define ADXL_INT2_Pin GPIO_PIN_11
#define ADXL_INT2_GPIO_Port GPIOD
#define MAG_SCL_Pin GPIO_PIN_12
#define MAG_SCL_GPIO_Port GPIOD
#define MAG_SDA_Pin GPIO_PIN_13
#define MAG_SDA_GPIO_Port GPIOD
#define MS5607_CS_Pin GPIO_PIN_0
#define MS5607_CS_GPIO_Port GPIOD
