TataThanapat/CURSR-V-Flight-Computer/(commit log)

2025-12-10 initial commit
    Initial schematic, layout, and file structures
    [Carrier board.kicad_pcb, Carrier board.kicad_sch, Main board.kicad_pcb, Main board.kicad_sch]
2025-12-16 Initial Update
    Mainboard schematic update - Added MCU, decoupling, Manual reset, 32MHz TCXO, SD card holder, SWD Tag-connect header, SPI sensors
    Mainboard layout update - Initial SPI routings
    .ioc update - Initial peripheral setups
    [Main board.kicad_pcb, Main board.kicad_sch, untitled.kicad_sch]
2026-02-12 Changed to single-board architecture
    SPI Layout #1. Shared bus close to USB D+-, might be bad for layout later.
    [Main board.kicad_pcb, Main board.kicad_sch, untitled.kicad_sch]
2026-03-10 Schematics completed + layout
    [Main board.kicad_pcb, Main board.kicad_sch, untitled.kicad_sch]
2026-03-16 Layout V1
    [Main board.kicad_pcb, Main board.kicad_sch]
2026-04-05 Final Layout (Pre-silkscreen)
    - Added 1M resistors in parallel with the igniters for static dissipation
    [Main board.csv, Main board.kicad_pcb, Main board.kicad_sch, untitled.kicad_sch]
2026-04-06 Minor Adjustment + Silkscreen
    [Main board.kicad_pcb, Main board.kicad_sch]
2026-06-17 Included IMU project
    [Main board.kicad_pcb, Main board.kicad_sch, untitled.kicad_sch]
