TataThanapat/CURSR-V-Flight-Computer/(notices)

Notices in the files:
FlightCompitor/Core/Inc/main.h:
Copyright (c) 2025 STMicroelectronics.
All rights reserved.
This software is licensed under terms that can be found in the LICENSE file
